nistordarius26h-ship-it/ga_ai_robot/media/gaairobotrender.png

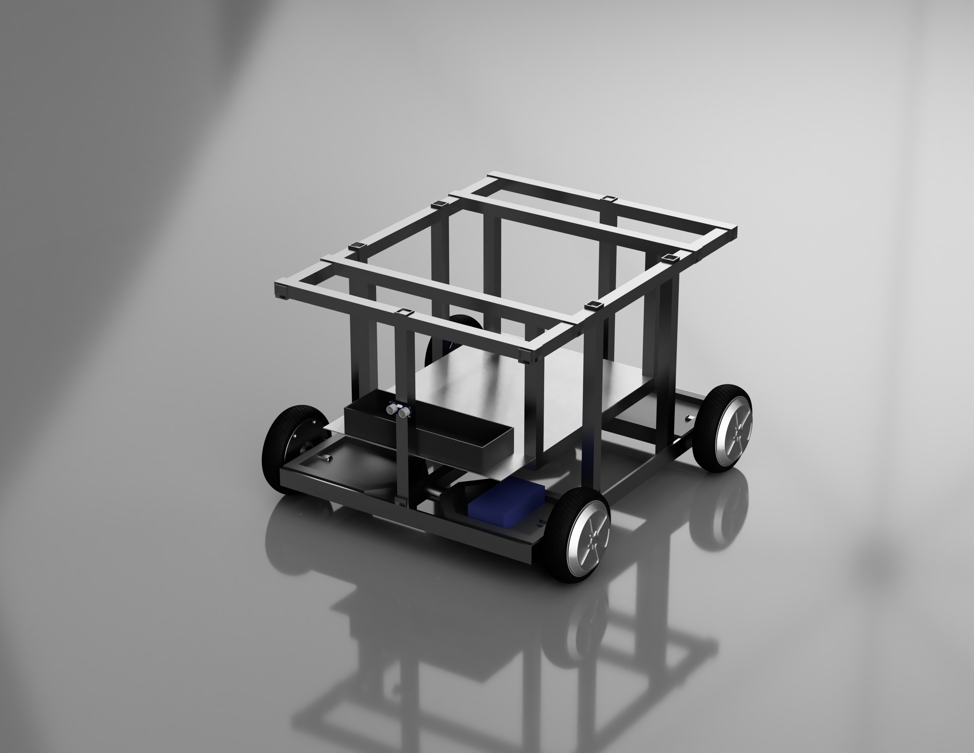
media/gaairobotrender.png
