nistordarius26h-ship-it/ga_ai_robot/docs/README.md

# Documentation

| Doc | Covers |
|---|---|
| [`1)robotics-electronics-hardware.md`](./1%29robotics-electronics-hardware.md) | Current hardware, controller terminals, sensors and expansion |
| [`2)electrical-engineering-pcb.md`](./2%29electrical-engineering-pcb.md) | Power, melted-feeder lesson, motor signal conditioning, single-PCB architecture |
| [`3)esp32-firmware.md`](./3%29esp32-firmware.md) | Current firmware, steering ramp and safety behavior |
| [`4)raspberry-pi-setup.md`](./4%29raspberry-pi-setup.md) | Pi setup, secure config, LTE-aware startup, MediaMTX |
| [`5)cloudflare-telegram-remote-access.md`](./5%29cloudflare-telegram-remote-access.md) | Cloudflare, Telegram, LTE boot race and TURN/CGNAT |
| [`6)ai-tracking-computer-vision.md`](./6%29ai-tracking-computer-vision.md) | YOLO11 + ByteTrack pipeline |
| [`7)3d-modeling-rendering.md`](./7%293d-modeling-rendering.md) | Fusion 360 mechanical design |
| [`8)custom-pcb-expansion.md`](./8%29custom-pcb-expansion.md) | PCB v1 connector/expansion plan |
