nistordarius26h-ship-it/ga_ai_robot/(commit log)

2026-07-31 Add main control code for ESP32 robot
    This file contains the main control code for an ESP32-based robot, including sensor readings, motor control, and communication handling.
2026-08-03 Update Telegram bot configuration to use placeholders
    Replaced hardcoded Telegram bot token and chat ID with placeholders for user configuration.
    [robot_app.py]
2026-08-11 Revise hardware documentation for clarity and detail
    Updated descriptions and components in the robotics hardware documentation, including changes to the Raspberry Pi, drivetrain motors, power sources, and sensor details.
2026-08-11 Revise electrical engineering documentation
    Updated power architecture and PCB design workflow sections for clarity and detail on components and design practices.
2026-08-11 Revise ESP32 firmware documentation for clarity
    Updated the ESP32 firmware documentation to reflect changes in sensor responsibilities, telemetry data, and safety behaviors. Clarified motor control implementation and added details on sensor wiring.
2026-08-12 Remove decoupling practice section from PCB doc
    Removed general decoupling practice recommendation for sensor modules.
2026-08-12 Clarify wiring style in PCB design section
    Updated PCB design description to clarify wiring style.
2026-08-12 Revise firmware note and sensor descriptions
    Updated notes on firmware compatibility and clarified sensor roles.
2026-08-26 Revise electrical engineering and PCB documentation
    Updated terminology and improved clarity in wiring and PCB sections. Consolidated design considerations and future board plans.
2026-08-26 Update ESP32 firmware documentation for clarity
    Revised firmware documentation for ESP32, improving clarity and detail on functionality, toolchain, and sensor integration.
2026-08-26 Refine Raspberry Pi setup documentation
    Updated the Raspberry Pi setup documentation for clarity and conciseness, including changes to installation steps, configuration details, and troubleshooting information.
2026-08-26 Improve clarity and conciseness in AI tracking doc
    Refined language for clarity and conciseness throughout the document. Adjusted sections on offboard inference, pipeline architecture, detection, tracking, kinematics, and adapting for the robot.
2026-08-26 Refine 3D modeling and rendering documentation
    Updated text for clarity and conciseness throughout the document, including sections on chassis design, file descriptions, workflow steps, and export format comparison.
2026-09-15 Update README to remove PCB and security sections
    Removed sections on PCB design exclusions and security guidelines from README.
2026-09-15 Revise installed modules and resistor specifications
    Updated module list and clarified resistor values for PCB v1.
2026-09-15 Revise wiring details and PCB v1 component list
    Updated wiring specifications and removed unnecessary components for PCB v1.
